ProfChristopherR/autoinver/Documentacion/diagrama_conexiones_autoinver.png

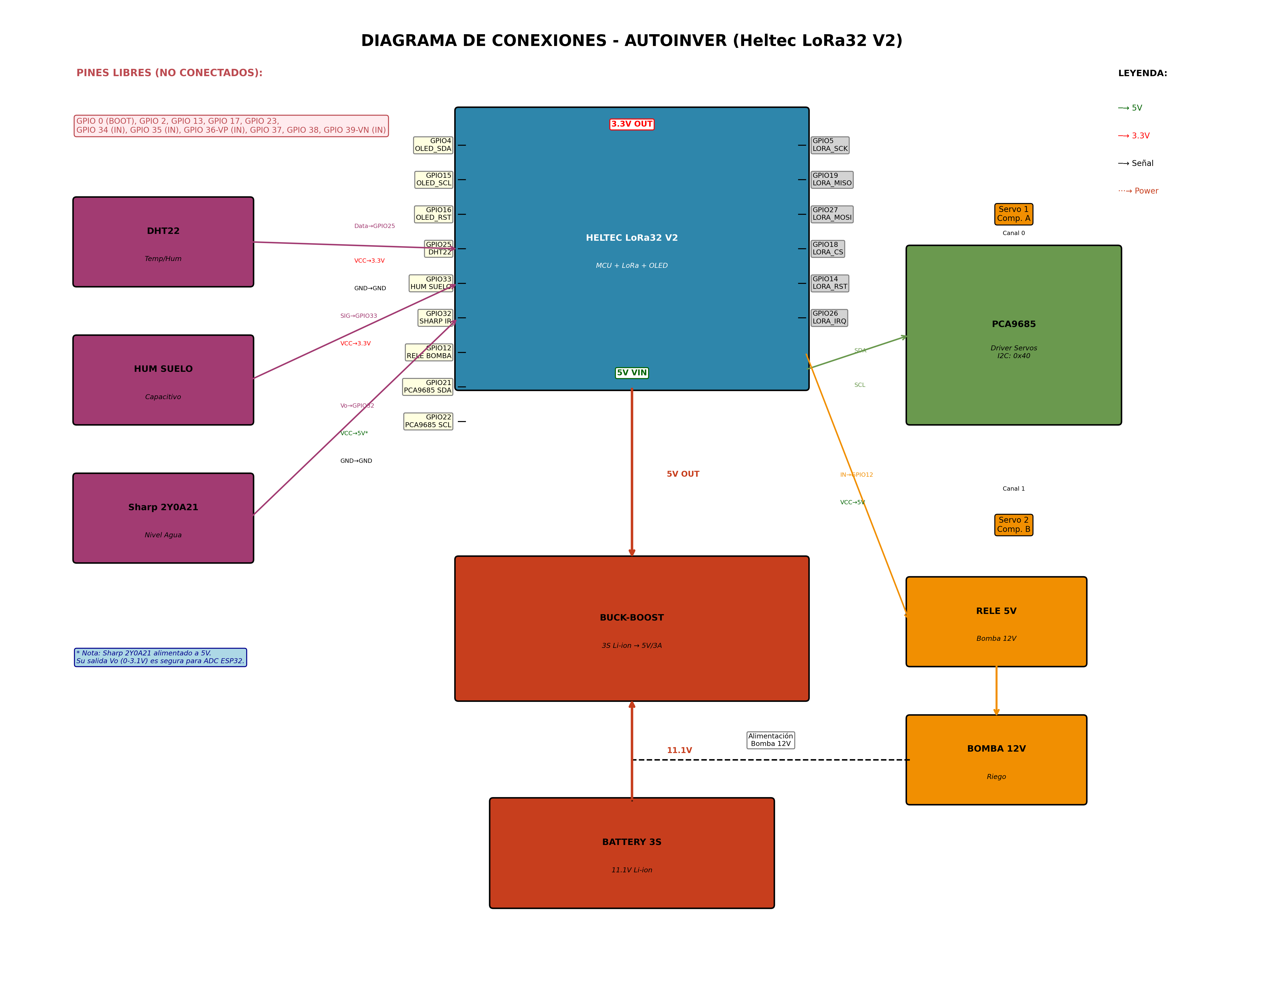
Documentacion/diagrama_conexiones_autoinver.png
