ProfChristopherR/autoinver/firmware/Autoinver_Nodo/config.h

/*
 * ╔═══════════════════════════════════════════════════════════════════════════╗
 * ║              AUTOINVER NODO v2.0 - ARCHIVO DE CONFIGURACIÓN              ║
 * ╚═══════════════════════════════════════════════════════════════════════════╝
 */

#ifndef CONFIG_H
#define CONFIG_H

#include <Arduino.h>

// ═══════════════════════════════════════════════════════════════════════════════
// CONSTANTES DE COMPILACIÓN
// ═══════════════════════════════════════════════════════════════════════════════

// Descomentar para activar logs detallados de sensores
// #define DEBUG_SENSORS

// ═══════════════════════════════════════════════════════════════════════════════
// PINES - Heltec LoRa32 V2
// ═══════════════════════════════════════════════════════════════════════════════

// --- Sensores ---
#define PIN_DHT 25     // DHT22 - Temperatura/Humedad
#define DHT_TYPE DHT22 //
#define PIN_SOIL 33    // Humedad suelo capacitivo (ADC)
#define PIN_HCSR04_TRIG 32 // HC-SR04 Trigger (salida digital)
#define PIN_HCSR04_ECHO 13 // HC-SR04 Echo (entrada 3.3V: usar divisor resistivo desde 5V)

// --- Actuadores ---
#define PIN_RELE 12       // Relé bomba 12V
#define CHANNEL_SERVO_A 0 // PCA9685 Canal 0 - Compuerta A
#define CHANNEL_SERVO_B 1 // PCA9685 Canal 1 - Compuerta B

// --- OLED Interno ---
#define PIN_OLED_SDA 4
#define PIN_OLED_SCL 15
#define PIN_OLED_RST 16
#define OLED_ADDR 0x3C

// --- Dimensiones OLED ---
#define SCREEN_W 128
#define SCREEN_H 64

// --- LoRa Interno (NO MODIFICAR) ---
#define PIN_LORA_SCK 5
#define PIN_LORA_MISO 19
#define PIN_LORA_MOSI 27
#define PIN_LORA_CS 18
#define PIN_LORA_RST 14
#define PIN_LORA_IRQ 26

// --- I2C PCA9685 ---
// El PCA9685 comparte el bus I2C del OLED (GPIO4/GPIO15).
// GPIO21 en Heltec LoRa32 V2 controla Vext y NO debe usarse como SDA.
#define PIN_SDA 4
#define PIN_SCL 15
#define PCA9685_ADDR 0x40

// ═══════════════════════════════════════════════════════════════════════════════
// CONFIGURACIÓN RADIO LoRa
// ═══════════════════════════════════════════════════════════════════════════════

#define LORA_FREQ 915E6 // Frecuencia 915 MHz (ISM Américas)
#define LORA_SF 7       // Spreading Factor 7
#define LORA_BW 125E3   // Bandwidth 125 kHz
#define LORA_CR 5       // Coding Rate 4/5
#define LORA_TXPOWER 17 // dBm

// ═══════════════════════════════════════════════════════════════════════════════
// INTERVALOS DE TIEMPO (ms)
// ═══════════════════════════════════════════════════════════════════════════════

#define SENSOR_INTERVAL_MS 1000 // Lectura sensores cada 1s (detección ágil de humedad)
#define TX_INTERVAL_MS 5000     // Transmisión LoRa cada 5s
#define DISPLAY_INTERVAL_MS 500 // Refresh OLED cada 500ms
#define SYNC_TIMEOUT_MS 10000   // Timeout sync hora 10s

// ── Control de Riego por Pulsos (Invernadero pequeño) ──
#define PUMP_PULSE_MS        1000   // TIEMPO ENCENDIDA (AUTO): 1 segundo de agua por pulso
#define PUMP_MANUAL_PULSE_MS 1000   // TIEMPO ENCENDIDA (MANUAL): 1 segundo exacto (pedido usuario)
#define PUMP_COOLDOWN_MS     2000   // TIEMPO APAGADA:   2 segundos de pausa/absorción entre pulsos

// ═══════════════════════════════════════════════════════════════════════════════
// PARÁMETROS DE CONTROL
// ═══════════════════════════════════════════════════════════════════════════════

#define TEMP_HYSTERESIS 1.5f      // °C de histeresis para compuertas
#define SOIL_HYSTERESIS 10.0f     // % de histeresis para riego
#define WATER_MIN_PCT 10.0f       // % mínimo de agua para permitir riego (corte de seguridad)
#define MANUAL_OVERRIDE_MS 600000 // 10 minutos de override manual
#define MAX_SYNC_ATTEMPTS 5       // Intentos máximos de sync hora

// ── Sensor Ultrasónico HC-SR04 (Nivel de Agua) ──
#define HCSR04_FULL_CM_DEFAULT  3.0f    // <= 3.0 cm -> 100% (tanque lleno)
#define HCSR04_EMPTY_CM_DEFAULT 10.0f   // >= 10.0 cm -> 0% (tanque vacío)
#define HCSR04_TIMEOUT_US       6000UL  // Timeout eco ~1m (máx 6ms por ping, no bloquea LoRa)

// ═══════════════════════════════════════════════════════════════════════════════
// SERVOS
// ═══════════════════════════════════════════════════════════════════════════════

#define SERVO_PULSE_MIN 150 // ~0.5ms @ 50Hz
#define SERVO_PULSE_MAX 600 // ~2.5ms @ 50Hz

// ═══════════════════════════════════════════════════════════════════════════════
// ZONA HORARIA
// ═══════════════════════════════════════════════════════════════════════════════

#define GMT_OFFSET_SEC (-4 * 3600) // GMT-4 (Chile continental)

// ═══════════════════════════════════════════════════════════════════════════════
// ESTRUCTURA DE CONFIGURACIÓN CALIBRABLE (persiste en NVS)
// ═══════════════════════════════════════════════════════════════════════════════

struct ConfigData {
  float waterFullCm  = HCSR04_FULL_CM_DEFAULT;  // cm con tanque lleno (<= 3 cm = 100%)
  float waterEmptyCm = HCSR04_EMPTY_CM_DEFAULT; // cm con tanque vacío (>= 10 cm = 0%)
  int soilMinADC  = 1400;    // ADC suelo mojado (en agua = capacitancia alta, voltaje bajo)
  int soilMaxADC  = 3200;    // ADC suelo seco (en aire = capacitancia baja, voltaje alto)
  int servo1Min   = 0;       // Grados mínimos compuerta A (calibración)
  int servo1Max   = 90;      // Grados máximos compuerta A
  int servo2Min   = 0;       // Grados mínimos compuerta B
  int servo2Max   = 90;      // Grados máximos compuerta B
  float tempThresh1 = 28.0f; // °C - Abrir compuerta A
  float tempThresh2 = 32.0f; // °C - Abrir compuerta B también
  float soilThresh = 40.0f;  // %  - Umbral riego
  int pumpDuration = 1000;   // ms - Duración de pulso de riego (1 segundo)
};

extern ConfigData g_config;

#endif // CONFIG_H
