ProfChristopherR/autoinver/(commit log)

2026-08-18 Fix: quitar ts_local del payload, limpiar buffer viejo, remover boton Config del dashboard
    [Autoinver_Gateway.ino]
2026-08-18 Gateway: implementar polling de comandos desde commands_queue
2026-08-18 Gateway: poll de comandos cada 2s para respuesta rapida de actuadores
2026-08-18 Nodo: PCA9685 en Wire1 (pines 21/22), proteccion bomba agua<10%, corte emergencia
2026-08-18 Fix dashboard: CDN de supabase-js daba 404, cambiar a jsdelivr
2026-08-18 Fix dashboard: renombrar cliente a supaClient (chocaba con global de la lib UMD)
2026-08-18 Nodo: escaner I2C en boot para diagnosticar PCA9685
2026-08-18 Nodo: PCA9685 al bus I2C del OLED (4/15) - GPIO21 controla Vext en Heltec V2
2026-08-18 Nodo: setOscillatorFrequency(27MHz) para clones PCA9685 + barrido de prueba en boot
2026-08-18 Dashboard: fix toggle modo auto, estado por frescura de datos, cola de comandos con cancelar, feedback en Actualizar
2026-08-18 Gateway: envio de buffer por lotes (1 POST por 20 registros) para no bloquear el loop
2026-10-28 feat(gateway): optimizar latencia de comandos a 2s y sincronización inmediata con Supabase (Opción A)
2026-10-29 fix(dashboard, firmware): evitar reseteo de controles a 0, sincronizar modo manual/auto y reactivación automática
2026-10-29 fix(control-mode): resolver desincronizacion total de modo auto/manual con botones dedicados y proteccion de telemetria
2026-10-29 feat(pump): pulso de riego en modo manual ajustado a 1.5s (dashboard y nodo)
2026-11-10 feat(dashboard): agregar selector y vista de grafico mixto (barras interconectadas con lineas) para 1h a 7d
2026-11-10 feat(dashboard): agregar linea de interconexion continua sobre las barras de suelo en grafico mixto
2026-11-10 feat(dashboard): transformar vista alternativa en grafico de barras gruesas estilizadas
2026-11-11 fix(dashboard,firmware): barras categoricas gruesas, botones rapidos servos y envio LoRa doble
2026-11-11 feat(nodo): reemplazar Sharp IR por ultrasonico HC-SR04 (3cm=100%, 10cm=0%) con filtro mediana
2026-11-12 fix(firmware): recepcion LoRa continua en nodo, auto-relax de servos y rafaga x4 en gateway
2026-11-12 fix(nodo): corregir control continuo de servos PCA9685 y pulso de bomba a 1s exacto
2026-11-12 fix(nodo,dashboard): recuperar I2C PCA9685 con Vext/100kHz/wakeup, barrido boot y texto 1s en web
2026-11-12 fix(nodo): corregir crash de puntero nulo en readPrescale antes de pca.begin() al arrancar
